GeorgeZhiXu/eink-photo-frame/bezel_left.scad

// ============================================================
// Front Bezel - Left Side (mitered 45° corners)
// ============================================================
include <common.scad>

module bezel_left() {
    bezel_side("left");
}

bezel_left();
