GeorgeZhiXu/eink-photo-frame/bezel_right.scad

// ============================================================
// Front Bezel - Right Side (mitered 45° corners)
// ============================================================
include <common.scad>

module bezel_right() {
    bezel_side("right");
}

bezel_right();
