GeorgeZhiXu/eink-photo-frame/bezel_top.scad

// ============================================================
// Front Bezel - Top Side (mitered 45° corners)
// ============================================================
include <common.scad>

module bezel_top() {
    bezel_side("top");
}

bezel_top();
