GeorgeZhiXu/eink-photo-frame/(list of files, cad)

Other CAD files:
base_bottom_bezel.scad
