GeorgeZhiXu/eink-photo-frame/(commit log)

2026-03-16 Photo frame for 13.3" Spectra 6 E-Ink display
    Parametric OpenSCAD design with:
    - 4 mitered bezel pieces (picture frame style, sharp inner corners)
    - Back panel split into top/bottom for 260mm print bed
    - L-shaped base stand with angled slot (12° tilt)
    - Base compartment for XIAO EE02 board + battery
    - Tongue-and-groove joints for back panel halves
    - Bezel channel system with derived inner lip width
    - Bottom bezel with narrowed channel for thin bottom rim
    - FPC ribbon routing with 4mm gap and 2mm right offset
    [assembly.scad, back_panel_bottom.scad, back_panel_top.scad, base_lid.scad, base_stand.scad, bezel_bottom.scad, bezel_left.scad, bezel_right.scad]
2026-03-16 Restructure bezel and panel dimensions
    - bezel_w is now total visible width (13.5mm, includes lip)
    - lip_overlap derived from display borders (border - visible_border)
    - lip_bottom derived from border_bottom (10.3mm)
    - channel and panel_rim derived from bezel layout
    - frame_d derived from back_thick + display_d + cavity_tol
    - Uniform bezel_w on all 4 sides (bottom has larger lip, thinner rim)
    - Sharp internal corners on bezel (display glass is rectangular)
    - Removed rim_extend hack, inner_lip_w = lip_overlap naturally
    [common.scad]
2026-03-16 Refactor bezels: subtractive approach, fix lip depth and wall thickness
    - Refactor bezel construction from additive (fill blocks) to subtractive
    (carve channels/lip from solid frame). Much easier to reason about.
    - Replace front_bezel_full() + per-side patches with parameterized
    bezel_side(side) module that handles all four sides correctly.
    - Fix bottom bezel: side channels at corners now properly clear for
    left/right panel rims.
    - Fix lip depth: was full frame_d, now correctly carves cavity leaving
    only inner_lip_d pressing on display glass.
    - Increase inner_lip_d 0.3 -> 0.6mm for better snap fit.
    - Increase cavity_tol 0.55 -> 0.85mm to maintain 0.25mm air gap.
    - Reduce wall_thick 2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
    [bezel_bottom.scad, bezel_left.scad, bezel_right.scad, bezel_top.scad, common.scad, debug_bezel_xsec.scad, debug_panel_bezel_fit.scad]
2026-03-17 Rework base stand and clean up CSG margins
    - Base: open-front box with angled cut (12° shelf for panel),
    open top (lid separate), board near back wall, buttons + USB-C
    on back wall.
    - Lid: updated dimensions for open-front base.
    - Remove CSG magic number offsets (-0.1/+0.2) from bezel and
    back panel. Use minimal epsilon (0.01) only where cuts go
    through boundary faces to avoid non-manifold warnings.
    - Fix channel carving depth: was overshooting into bezel face
    by 0.1mm (lip measured 0.7 instead of 0.6, channel wall 1.1
    instead of 1.2). Now exact.
    - wall_thick: 2.4 -> 1.2mm.
    [base_lid.scad, base_stand.scad, common.scad]
2026-03-17 Update display_in_panel colors, remove ghost overlays; fix assembly bezel offset for open-front base
    [assembly.scad, display_in_panel.scad]
2026-03-17 Update base stand with precise board measurements
    - Board dimensions: 80.2x41.2mm, hole edges 2.4mm (measured)
    - Remeasured component positions on back wall (USB-C, buttons, switch)
    - Component Z heights: USB-C 3.2mm, buttons 1.8mm, switch 3.0mm below board
    - USB-C port: proper rounded rectangle with $fn=40
    - Button holes: 2.8mm (2.4mm actual + 0.4mm clearance)
    - Switch slot: 1.6mm dial + 2mm travel + clearance
    - Standoff height: 6.2mm (5.8mm tallest component + clearance)
    - Front standoff 18mm from base front edge
    - Board edge flush with back wall + 0.2mm clearance
    - Stand depth reduced to 58.6mm
    - Base wall matched to outer_wall (2mm) for bezel fusion
    - Removed ghost panel from assembly vi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
    [assembly.scad, base_stand.scad, common.scad]
2026-03-17 increase tolerance
    [base_stand.scad]
2026-03-19 Widen base to frame_w, shift board 2mm back, full assembly view
    - Base width now matches frame_w (231.8mm) for battery connector room
    - Board shifted 2mm further from front (board_y offset 18->20mm)
    - stand_foot_depth increased 58.6->60.6mm to accommodate board shift
    - Lid updated for wider base
    - photo_frame.scad: full assembly with all parts positioned and tilted
    - Base stand comments updated with side-view diagram
    [assembly.scad, base_lid.scad, base_stand.scad, common.scad, photo_frame.scad]
2026-03-19 Remove lid finger pull, fix lid orientation in assembly, rename assembly to base_bottom_bezel
    [base_bottom_bezel.scad, base_lid.scad, photo_frame.scad]
2026-03-19 Split base into 3 parts, round left/right edges
    - base_stand: open-front/back/top U-shape with rounded left/right
    vertical edges, standoff marker holes (0.2mm) on floor
    - base_back_wall: separate piece with USB-C, buttons, switch slot
    - base_standoffs: 4 separate cylinders for gluing or lid mounting
    - Removed demo_wall_extension.scad
    - stand_foot_depth: 58.6 -> 60.6mm (board shifted 2mm back)
    [base_back_wall.scad, base_bottom_bezel.scad, base_stand.scad, base_standoffs.scad, common.scad]
2026-03-28 Add combined base stand and 3D printable screws
    - base_stand_combined.scad: single-piece base from pre-split design
    with rounded left/right edges and all cutouts
    - screws.scad: friction-fit bolts and snap-fit pins for board mounting
    - Fix board_surface_z in base_back_wall
    - Update base_bottom_bezel to use combined stand
    [base_back_wall.scad, base_bottom_bezel.scad, base_stand_combined.scad, screws.scad]
2026-04-20 refine base and bezel
    [base_bottom_bezel.scad, base_stand_combined.scad, common.scad]
